ryangadz/3DPrinters/README.md

# 3DPrinters
printer configurations and hardware modifications
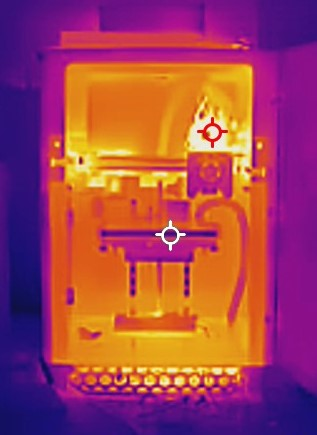
[picture p1: ThermalImageV0.jpg]
centered image
