ryangadz/3DPrinters/UniversalParts/AirFilter/Filter.png

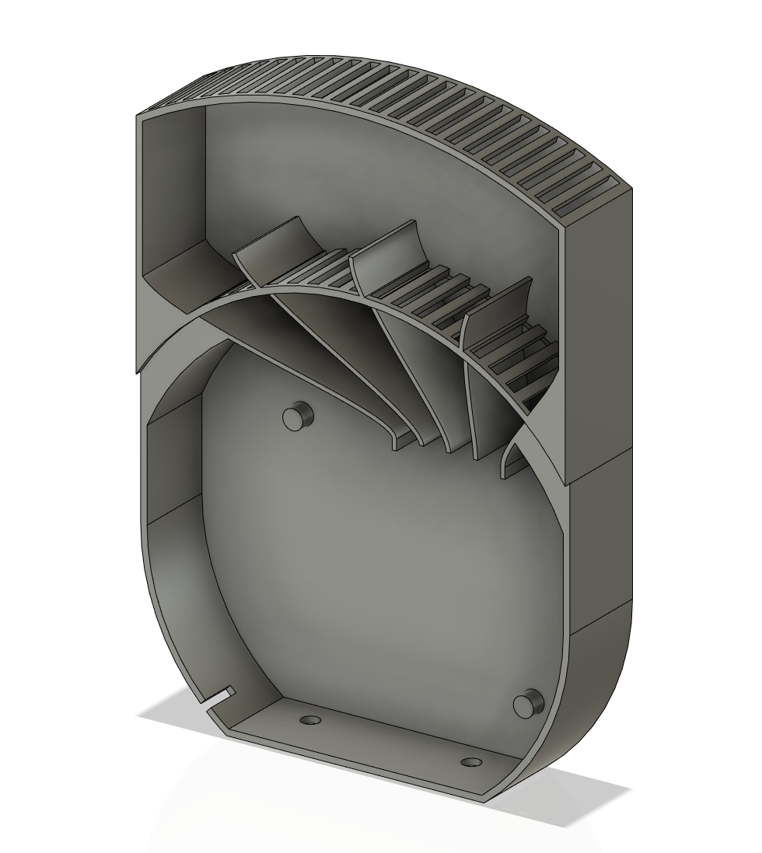
UniversalParts/AirFilter/Filter.png
