ryangadz/3DPrinters/UniversalParts/AirFilter/FilterCap.png

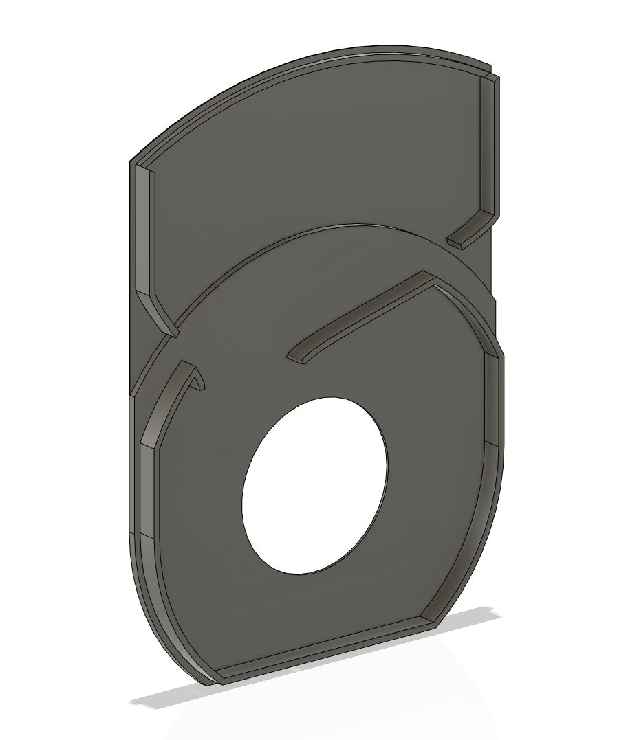
UniversalParts/AirFilter/FilterCap.png
