ryangadz/3DPrinters/UniversalParts/StepperFanMount/1661630557196.jpg

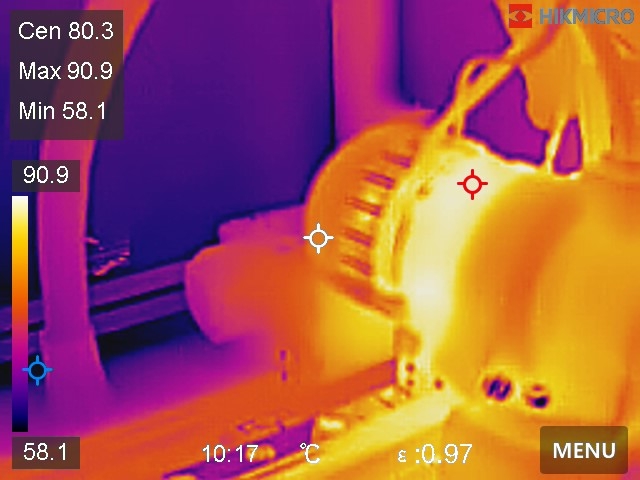
UniversalParts/StepperFanMount/1661630557196.jpg
