ryangadz/3DPrinters/Voron0/Mods/Toolhead/ToolheadAssembly.step

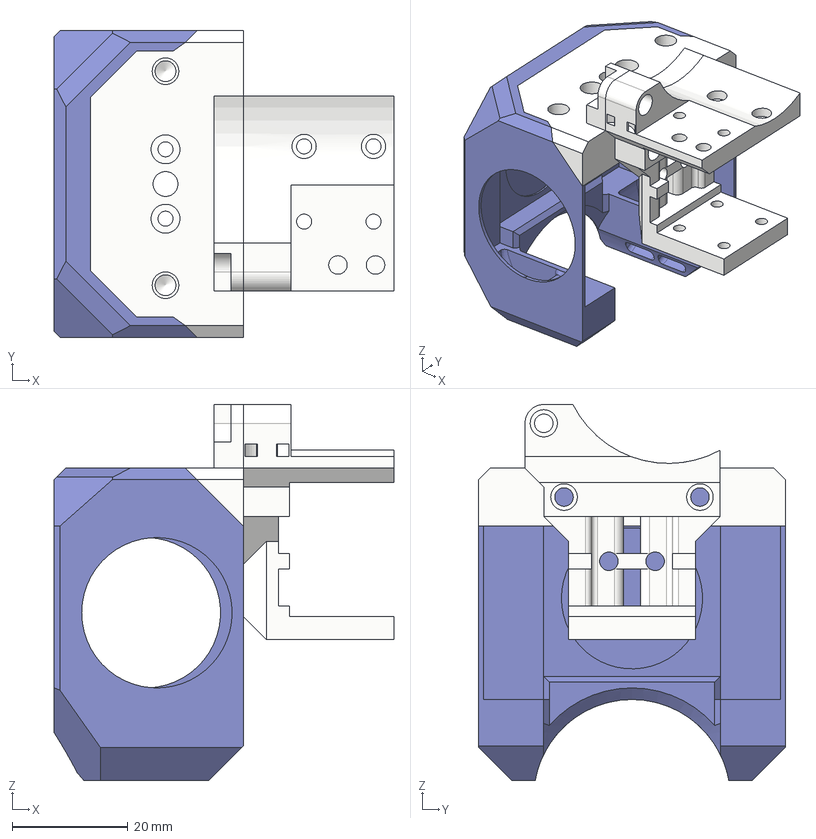
[picture p19: CAD file, 2022-09-10]
Voron0/Mods/Toolhead/ToolheadAssembly.step
58.7 x 53.0 x 65.0 mm
