ryangadz/3DPrinters/UniversalParts/AirFilter/Filter05.3mf

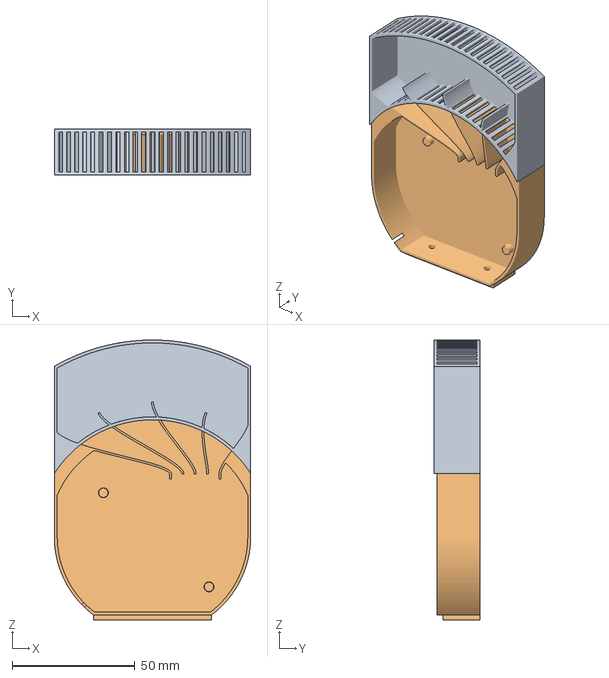
[picture p20: CAD file, 2022-09-10]
UniversalParts/AirFilter/Filter05.3mf
80.0 x 18.8 x 114.0 mm
