ryangadz/3DPrinters/UniversalParts/KnobCaps/BedTensionerKnob.3mf

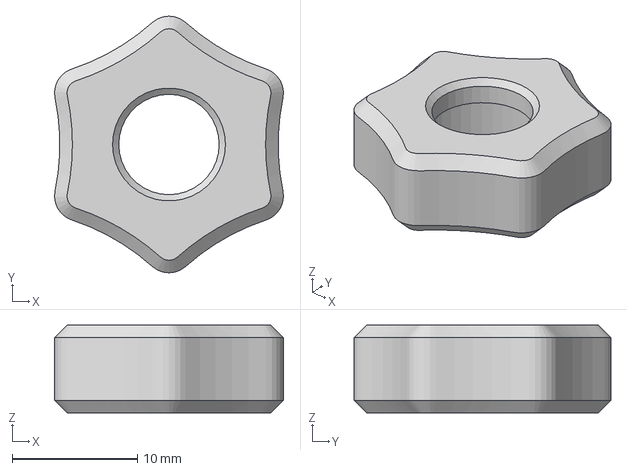
[picture p21: CAD file, 2022-08-28]
UniversalParts/KnobCaps/BedTensionerKnob.3mf
18.3 x 20.5 x 7.00 mm
