ryangadz/3DPrinters/UniversalParts/StepperFanMount/StepperFanMount.3mf

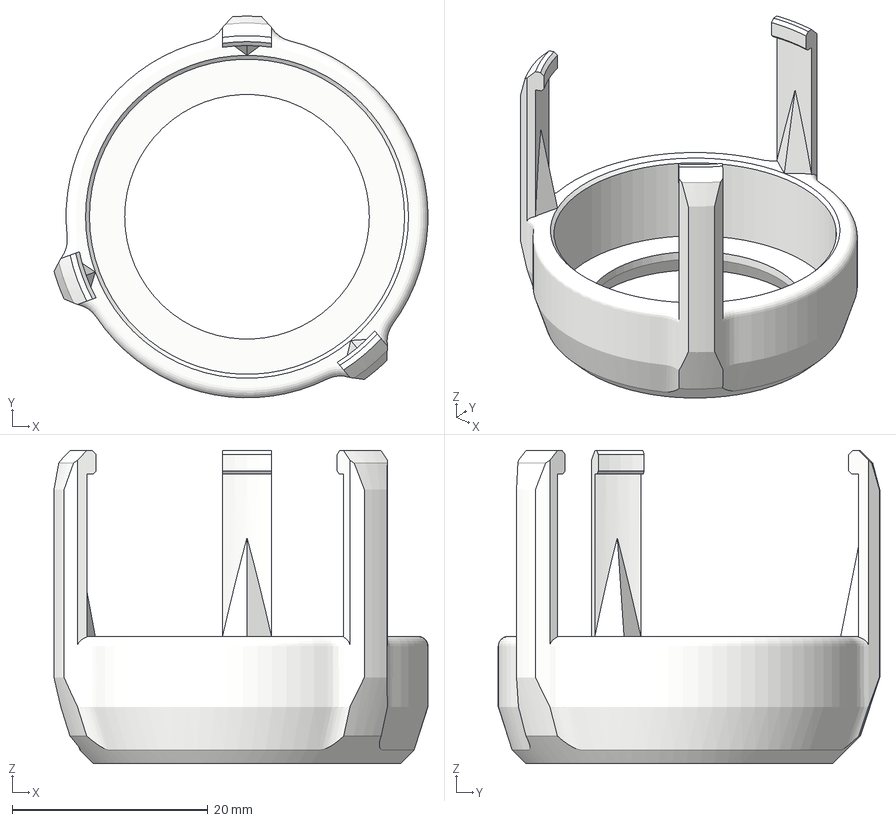
[picture p22: CAD file, 2022-08-28]
UniversalParts/StepperFanMount/StepperFanMount.3mf
38.2 x 39.0 x 32.0 mm
