ryangadz/3DPrinters/Voron0/Mods/DualRailGantry/GantryLeft.3mf

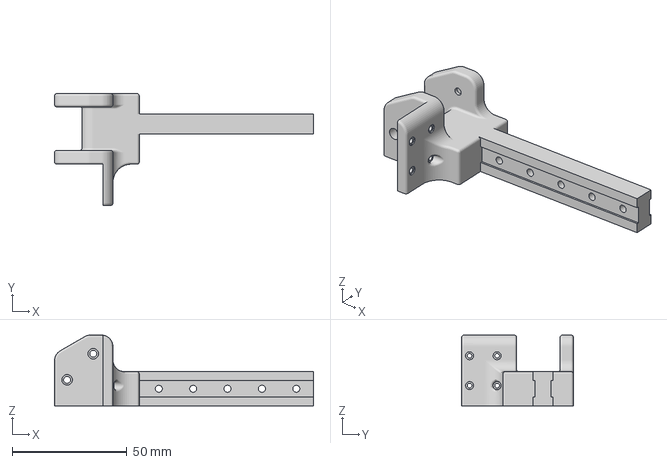
[picture p23: CAD file, 2022-08-28]
Voron0/Mods/DualRailGantry/GantryLeft.3mf
113.0 x 48.8 x 30.9 mm
