ryangadz/3DPrinters/Voron2/HermitCrab/ToolPlate.3mf

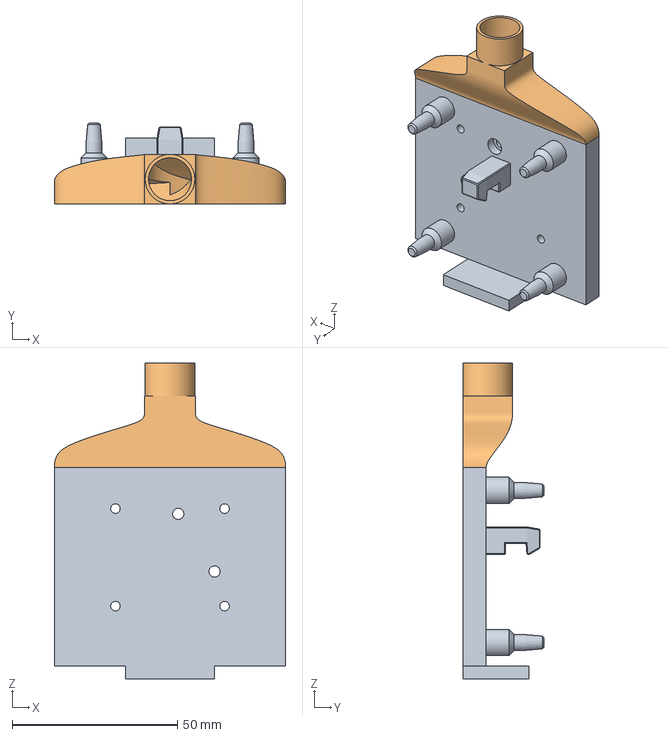
[picture p24: CAD file, 2022-12-29]
Voron2/HermitCrab/ToolPlate.3mf
70.0 x 24.5 x 95.6 mm
