ryangadz/3DPrinters/Voron0/Mods/DualRailGantry/GantryRight.3mf

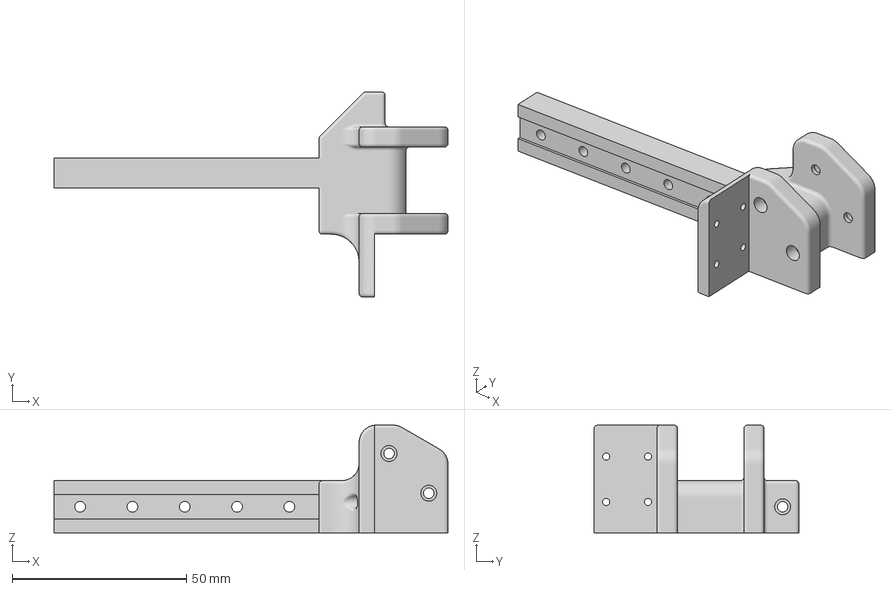
[picture p25: CAD file, 2022-08-28]
Voron0/Mods/DualRailGantry/GantryRight.3mf
113.0 x 58.8 x 30.9 mm
