ryangadz/3DPrinters/Voron0/Mods/Toolhead/BlockMount.3mf

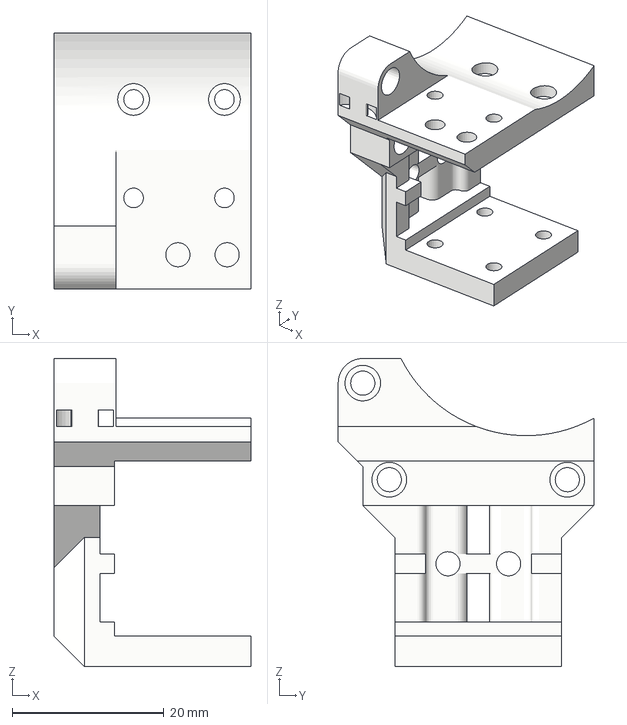
[picture p26: CAD file, 2022-08-28]
Voron0/Mods/Toolhead/BlockMount.3mf
26.0 x 33.8 x 40.7 mm
