ryangadz/3DPrinters/Voron2/HermitCrab/XYJoint.3mf

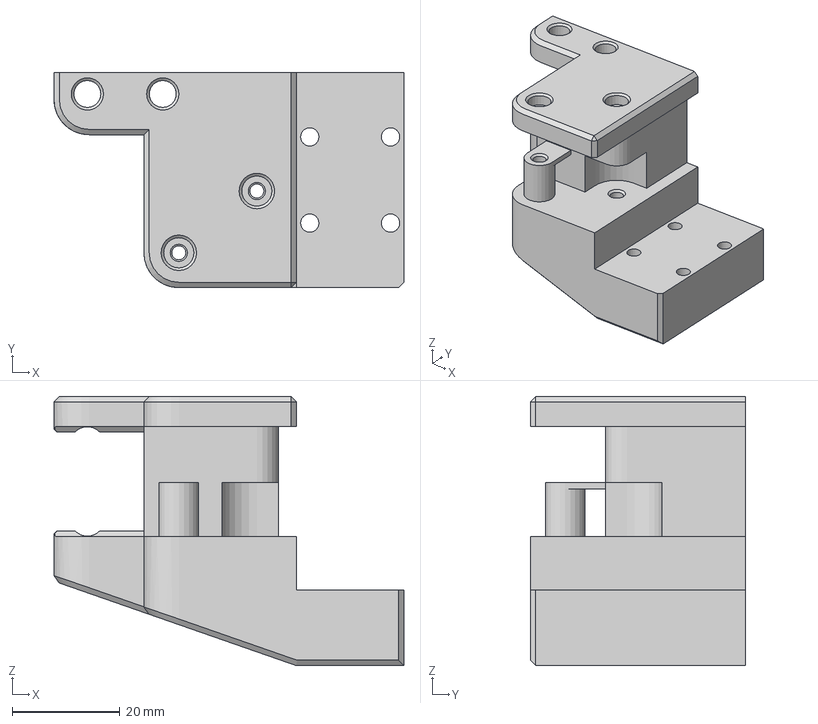
[picture p27: CAD file, 2022-12-29]
Voron2/HermitCrab/XYJoint.3mf
65.0 x 40.0 x 50.0 mm
