ryangadz/3DPrinters/Voron0/Mods/DualRailGantry/BlockMount.3mf

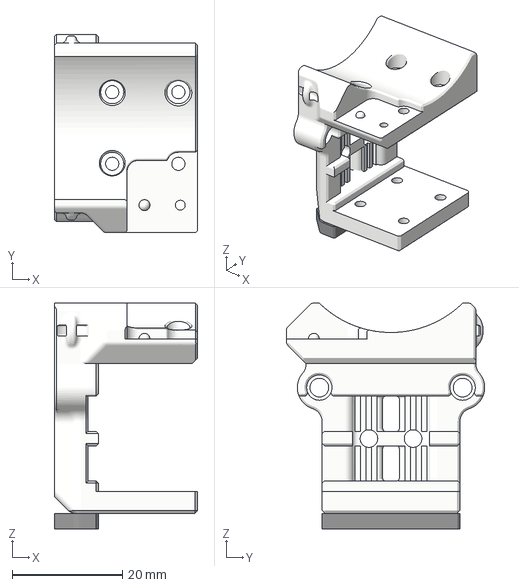
[picture p28: CAD file, 2022-08-28]
Voron0/Mods/DualRailGantry/BlockMount.3mf
26.0 x 36.0 x 41.0 mm
