ryangadz/3DPrinters/Voron0/Mods/Toolhead/ToolMount.3mf

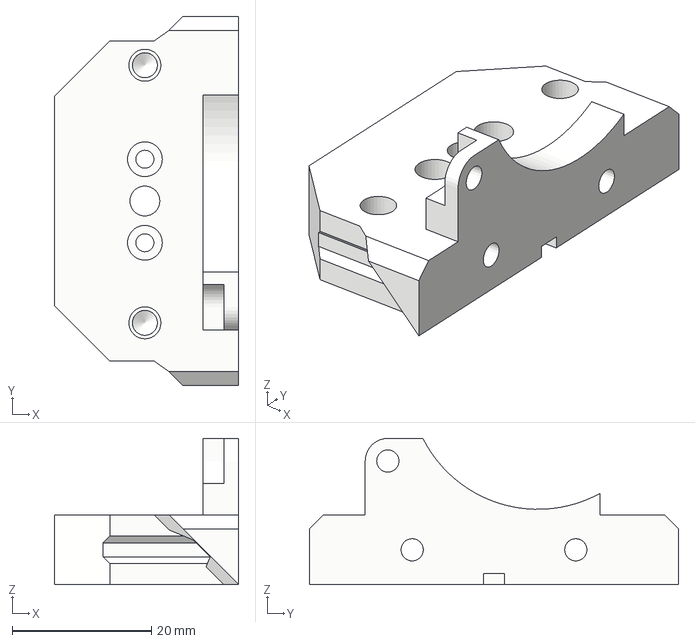
[picture p29: CAD file, 2022-08-28]
Voron0/Mods/Toolhead/ToolMount.3mf
26.5 x 53.0 x 21.0 mm
