ryangadz/3DPrinters/Voron0/Mods/Toolhead/FanCowl.3mf

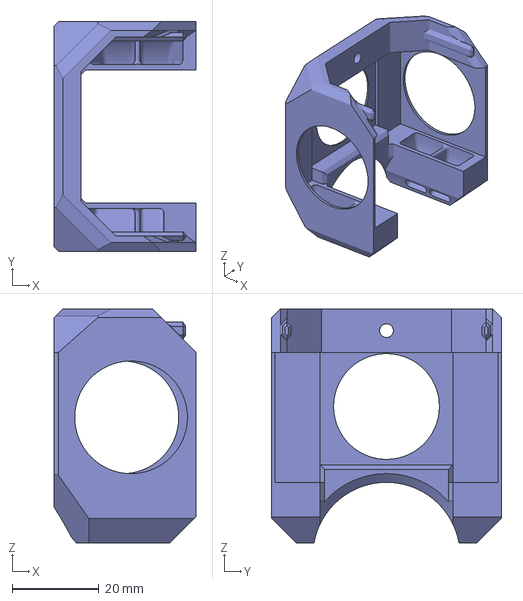
[picture p30: CAD file, 2022-08-28]
Voron0/Mods/Toolhead/FanCowl.3mf
32.7 x 53.0 x 54.0 mm
