ryangadz/3DPrinters/(list of files, cad)

Other CAD files:
UniversalParts/KnobCaps/ExtruderKnobCap.3mf
UniversalParts/AirFilter/AirFilter.f3d
UniversalParts/AirFilter/Filter05.f3d
UniversalParts/StepperFanMount/StepperFanMount.f3d
Voron0/Mods/DualRailGantry/DualRailGantry.f3d
Voron2/HermitCrab/ToolPlate.f3z
Voron2/HermitCrab/XYJoint.f3z
