ryangadz/3DPrinters/Voron0/Configs/Macros/macros.cfg

[gcode_macro Purge_Line]
gcode: 
  G0 X20 Y1 Z1 F6000 ; go to start purge spot
  G0 Z0.25 F6000 ; lower to start purge
  G92 E0 ; zero out extrusion distance
  G1 E0.2 F3600 ; unretract filament
  G1 X30 E0.9 F1000 ; intro line thin
  G1 X80 E12 F1000 ; intro line thick
