ryangadz/3DPrinters/(commit log)

2022-07-06 purge line macro
    [macros.cfg]
2022-08-28 fan mount cad files and photos
    [StepperFanMount.3mf, StepperFanMount.f3d]
2022-08-28 Dual Rail directions
    [BlockMount.3mf, DualRailGantry.f3d, ExtruderKnobCap.3mf, GantryLeft.3mf, GantryRight.3mf]
2022-08-28 Orbiter Mosquito Toolhead
    [BlockMount.3mf, FanCowl.3mf, ToolMount.3mf]
2022-08-28 Link to stepper fan mount
2022-08-28 Knob Caps
    [BedTensionerKnob.3mf, ExtruderKnobCap.3mf]
2022-09-10 Toolhead files
    [ToolheadAssembly.step]
2022-09-10 air filter files
    [AirFilter.f3d, Filter05.3mf, Filter05.f3d]
2022-12-29 hermit crab fit tests
    [ToolPlate.3mf, ToolPlate.f3z, XYJoint.3mf, XYJoint.f3z]
